LuckyMan23129/Flute/Schematic/Schematic.pdf

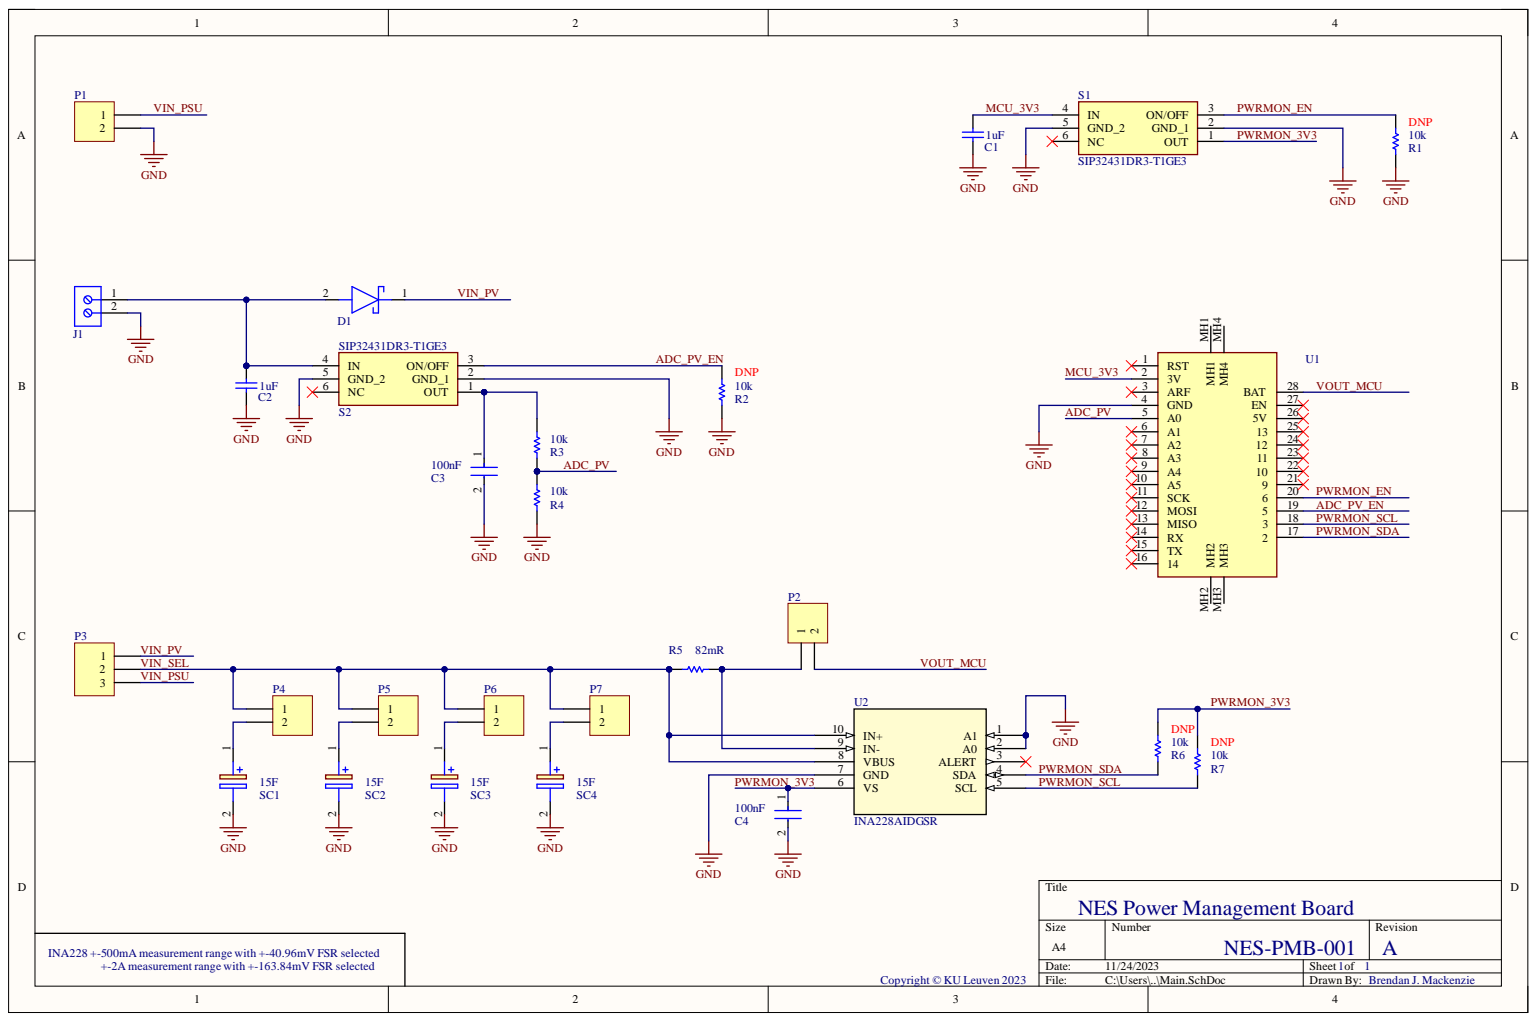
[picture p1: page 1]

Title
NES Power Management Board

INA228 +-500mA measurement range with +-40.96mV FSR selected

+-2A measurement range with +-163.84mV FSR selected
